dgrujic/glow_sg13g2/README.md

# GLOW-SG13G2

GLOW-SG13G2 (Gate Library for Open Flow) is a library of CMOS digital standard cells for [IHP SG13G2](https://github.com/IHP-GmbH/IHP-Open-PDK) process. 

The primary objective of this project is to design a rich library of standard digital cells that can be used in open source digital tools.
As a by-product it also provides a work flow that can be used to design new standard cells for IHP SG13G2 process.

An effort has been made to make the work flow process-agnostic as much as possible, so that it could be used with other PDKs that support open source tools.

# Funding

This project is funded through [NGI0 Commons Fund](https://nlnet.nl/commonsfund), a fund established by [NLnet](https://nlnet.nl) with financial support from the European Commission's [Next Generation Internet](https://ngi.eu) program. Learn more at the [NLnet project page](https://nlnet.nl/project/GLOW-SG13G2).

[NLnet foundation logo](https://nlnet.nl)
[NGI Zero Logo](https://nlnet.nl/commonsfund)

# Quick start guide

Work in progress...

# Documentation 

Work on project documentation is in progress, and can be accessed [here](https://dgrujic.github.io/glow_sg13g2/)

# License

The GLOW-SG13G2 library is released under the [Apache 2.0 license](LICENSE).

The copyright details are:
    
    Copyright 2026 Dr. Dušan Grujić

    Licensed under the Apache License, Version 2.0 (the "License");
    you may not use this file except in compliance with the License.
    You may obtain a copy of the License at

       https://www.apache.org/licenses/LICENSE-2.0

    Unless required by applicable law or agreed to in writing, software
    distributed under the License is distributed on an "AS IS" BASIS,
    WITHOUT WARRANTIES OR CONDITIONS OF ANY KIND, either express or implied.
    See the License for the specific language governing permissions and
    limitations under the License.
