dgrujic/glow_sg13g2/doc/workflow/src/SUMMARY.md

# GLOW Workflow

- [Introduction](./introduction.md)
- [Installation](./installation.md)
- [A short overview of ASIC digital design flow](./digital_flow_overview.md)
- [Standard cell design](./standard_cell_design.md)
- [Design flow](./design_flow.md)
- [GLOW Utilities](./glow_utils.md)
