dgrujic/glow_sg13g2/(commit log)

2026-04-28 Added support for ppar function in Symsubcircuit to enable the creation of parametrized hierarchical circuits.
2026-04-30 Minor bug fixes. Added Symcheck class that can perform various checks on a given circuit.
2026-05-04 Added device/node anonimization method to Symsubcircuit.
2026-05-05 Bugfix in Symsubcircuit flatten method. Added test for node/device anonimize.
2026-05-09 Minor bugfix in printing power and gnd terminal names.
2026-05-09 Added tie_low circuit test case for Symsim and corrected some corner-case bugs.
2026-05-15 Updated documentation on overview of a digital implementation flow.
2026-05-24 Added initial glow_parcells and inverter cell. Corrected MOSFET model names for SG13G2 process.
2026-05-25 Changed the simulation algorithm in Symsim to build equivalent circuits and solve them using MNA forumulation.
2026-06-09 Added an option to generate MOSFETs as subcircuits to support VerilogA models. Changed default behaviour to use the VerilogA models.
2026-06-09 Added parasitic network filtering in Netlist.
2026-06-09 Bugfix in Netlist to ignore case.
2026-06-09 Added initial ngspice support for analog simulation of circuits.
2026-06-21 Updated D flip-flop setup & hold tests. Corrected setup time calculation for the case of inverted output.
2026-07-30 Edited schematics of inv_par and invz_par for better readibility.
2026-07-30 Corrected nand3_par and nand4_par schematics.
2026-08-31 Added ngcombsim utility that can be used to determine/check a combinatorial circuit function from SPICE netlist by simulating it in NGSPICE.
2026-09-21 Fixed mdbook limitation for rendering LaTex, and switched to MathJax.
2026-10-05 Updated Symsim combcheck to print the symbol mapping.
2026-10-07 Changed the code to use cell name and pin list from cell info structure.
2026-10-10 Corrected pin list.
2026-10-11 Switched to YAML cell manifest. Manifest contains information about cell groups, pin information, functional description, and available cells.
2026-10-13 Fixed a bug in detecting duplicate circuit element names.
2026-10-19 Added symbols and schematics of gates.
2026-10-20 Added symbols and schematics for D flip-flops.
2026-10-23 Added gate schematics and symbols.
2026-10-24 Changed printing of warning message to comply with verbose flag.
2026-10-25 Switched table formatting code to use the tabulate library.
